Mayssam-Hergli/IoT-Cappucin/camera/results/cv_yolo_confusion.png

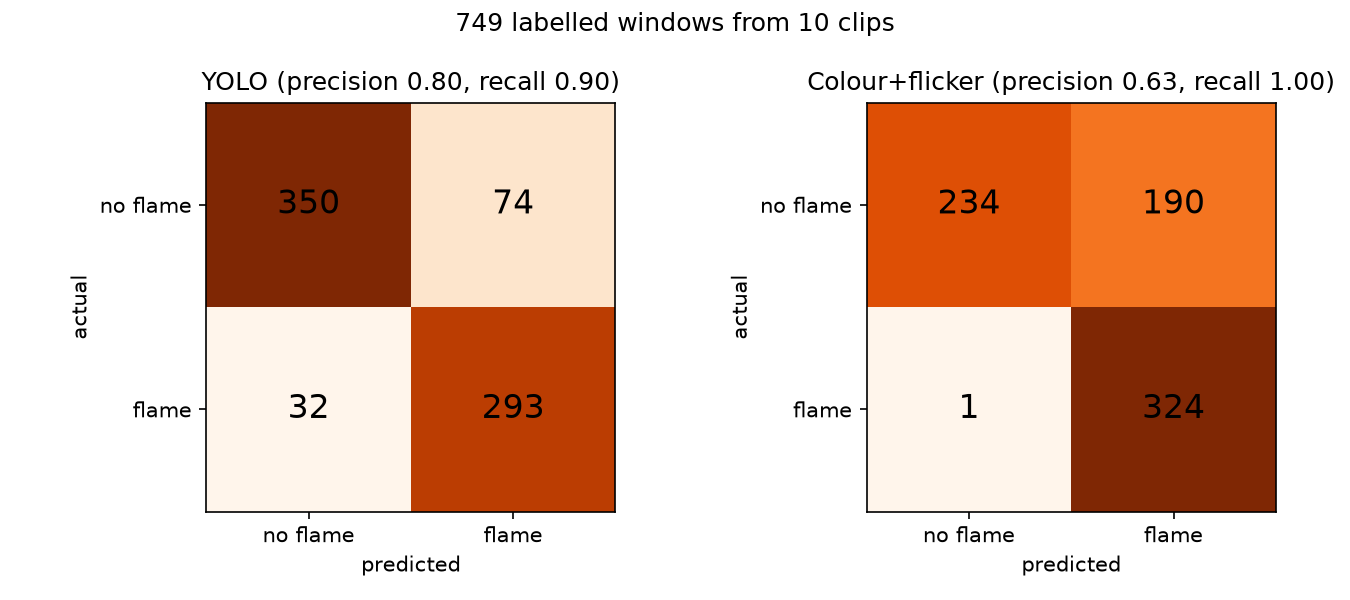
camera/results/cv_yolo_confusion.png
