Mayssam-Hergli/IoT-Cappucin/firmware/ember_esp32/secrets.example.h

// Copy this file to secrets.h (same folder) and fill in the values from the team chat.
#pragma once
const char* WIFI_PASS = "PUT_HOTSPOT_PASSWORD_HERE";
const char* EMBER_KEY = "PUT_THE_32_HEX_TEAM_KEY_HERE";
