Mayssam-Hergli/IoT-Cappucin/ember_secrets.example.py

# Copy this file to ember_secrets.py and fill in the values (from the team chat).
EMBER_KEY = "PUT_THE_32_HEX_TEAM_KEY_HERE"
ADMIN_PASSWORD = "choose-an-admin-password"
VIEWER_PASSWORD = "choose-a-viewer-password"
