Mayssam-Hergli/IoT-Cappucin/(commit log)

2026-11-07 Keep later stages hidden until earlier ones are solved
2026-11-08 Add EMBER server, dashboard, security tools and ESP32 firmware
    - server.py: signed ingest (HMAC-SHA256), replay protection, login + roles,
    command queue with ACK, events log, TLS (adhoc) with keep-alive
    - templates/: login page and live dashboard (levels, why bars, camera,
    comparisons, commands, voice alerts, event log)
    - fake_esp32.py (simulated board) and attack_test.py (security checks)
    - ember_esp32/: firmware with rules fallback, placeholder model.h, ember_link.h
    - link_test/: minimal sketch to test the ESP32 -> server link
    - Key and passwords live in ignored files; copy the *.example files
2026-11-08 Add camera layer: YOLOv8n fire detector, recorder, evaluation and results
    cv_flame.py scores each frame (colour+flicker rule or the YOLOv8n fire model via --yolo)
    and POSTs the signed score and a small annotated frame to /api/cv.
    cv_record.py + cv_eval.py record labelled 10-frame windows and compute the confusion
    matrix: YOLO precision 0.80 / recall 0.90 vs the colour rule 0.63 / 1.00 on 749 windows
    from 10 clips. The model is rabahdev/fire-smoke-yolov8n (D-Fire, AGPL-3.0) exported to ONNX.
    [cv_yolo_data.csv]
2026-11-08 Add docs, planning sheet and project README
    docs/spec: IoT Spark 4.0 specification book and the filled team planning sheet (PDF + Markdown).
    docs/briefs: team system brief, the EMBER pitch and the camera-layer brief.
    docs/CONTEXT.md and TEAM_PLANNING_SHEET.md: living team context.
    README.md: map of the repository.
2026-11-08 firmware: active buzzer, hw_test results
    [ember_esp32.ino]
2026-11-08 Add simulated temperature/light sensor controls to the dashboard
    - server.py: accept admin-only sim_* commands (heat, flame, hand, torch,
    calm, dht_fault), delivered to the board through the signed reply
    - dashboard: "Simulated sensors" buttons, (SIM) labels and a SIMULATED chip
    driven by the board's sim_sensors / sim_scene fields
    - fake_esp32.py: obeys the sim_* buttons
    - config.py: simple-rule heat threshold 0.2 degC/s (DHT11 whole degrees)
2026-11-08 firmware: simulated DHT+LDR scenes (sim_* commands), link to server via ember_link.h, sim_sensors/sim_scene in payload; tools/serial_script.py
    Compiles; not yet verified on the board.
2026-11-08 firmware: link works (TLS+HMAC, link_ok=1); SSID override in secrets.h; baselines never learn a leak/torch; ST shows link_ok + last_cmd
    Sim scenes verified over Serial: hand/torch NORMAL, heat WARNING fire, flame ALARM fire + valve closed, dht fault no alarm.
    [ember_esp32.ino]
2026-11-08 tools: demo_live.py one-take ALARM -> WARNING -> NORMAL driver (reboot via RTS, survives USB drops)
